Dioxin911/armachat/PCB/armachat.brd

## EAGLE design PCB/armachat.brd (2025-07-06)

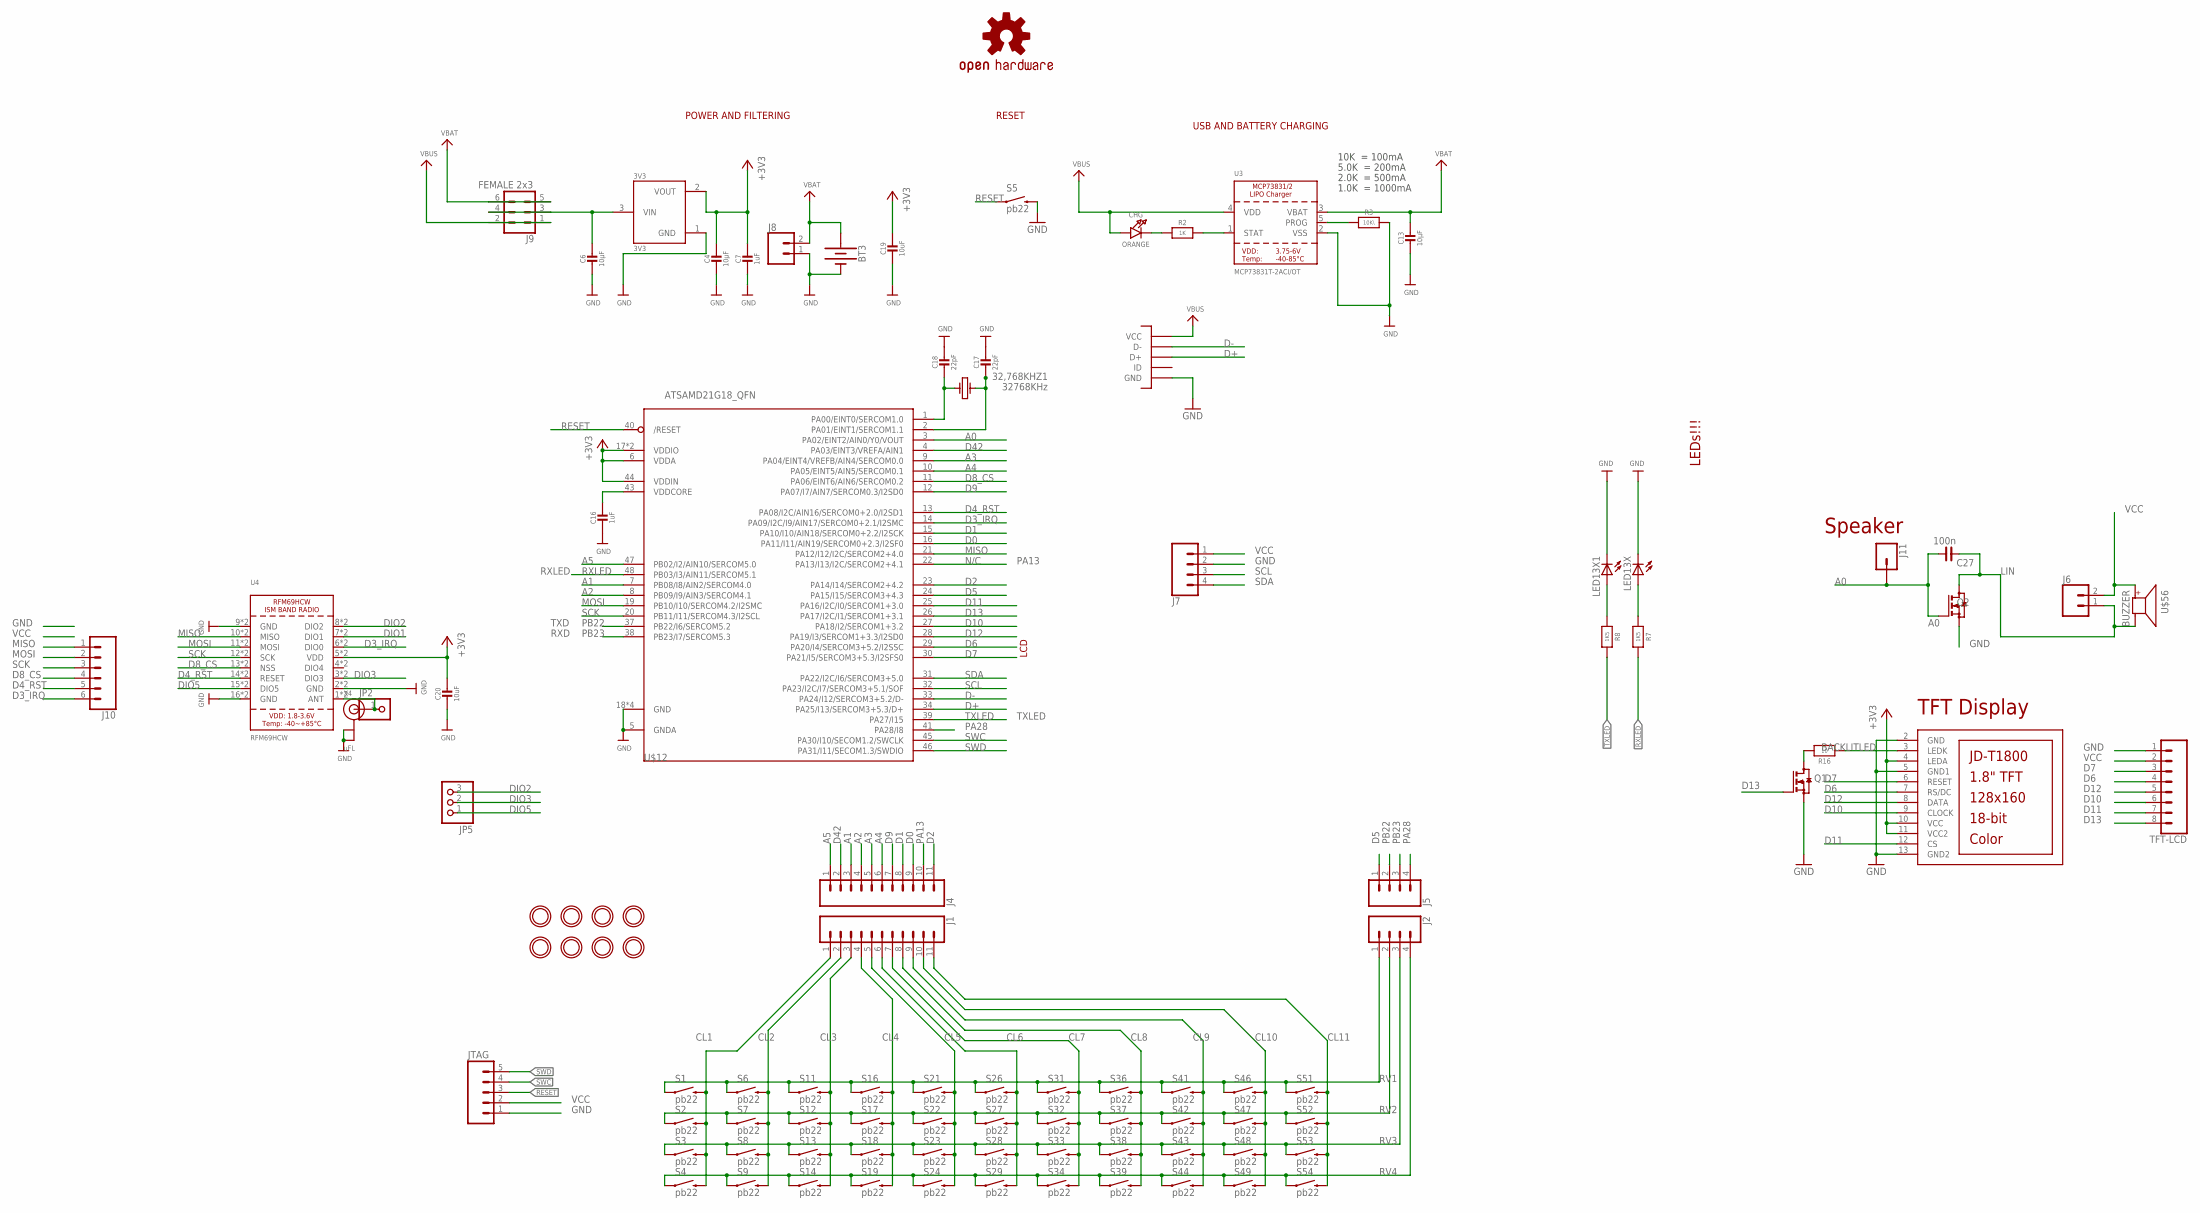
[picture p1: schematic armachat.sch]

Parts:
3V3: 3V3; SOT23
32,768KHZ1: 32768KHz; KX-327LT
BT3: BATTERY; 18650_HOLDER_SINGLE_THROUGH-HOLE
C4, C6, C13: 10µF; 0805-NO
C7, C16: 1uF; 0603-NO
C17, C18: 22pF; 0603-NO
C19: 10uF; 0603-NO
C20: 10uF; 0805-NO
C27: 100n; C0603
CHG: ORANGE; CHIPLED_0805_NOOUTLINE
J1, J4: CONN_111X11_NO_SILK; 1X11_NO_SILK
J2, J5, J7: CONN_041X04_NO_SILK; 1X04_NO_SILK
J6, J8: CONN_021X02_NO_SILK; 1X02_NO_SILK
J9: FEMALE 2x3; 2X3
J10: CONN_06NO_SILK_FEMALE_PTH; 1X06_NO_SILK
J11: CONN_01; 1X01
JP2: HEADER-1X1ROUND; 1X01_ROUND
JP5: HEADER-1X3ROUND; 1X03_ROUND
JTAG: M051.27MM; 1X05-1.27MM
LCD1: DISP_LCD_JDT1800; JD-T1800
LED13X, LED13X1: LED3MM
LOGO3: OSHW-LOGOS; OSHW-LOGO-S
Q1, Q2: BSS123; SOT23
R2: 1K; 0603-NO
R3: 10K\; 0603-NO
R7, R8: 1K5; _0603MP
R16: 10; 0603-NO
S1, S2, S3, S4, S6, S7, S8, S9, S11, S12, S13, S14, S16, S17, S18, S19, S21, S22, S23, S24, S26, S27, S28, S29, S31, S32, S33, S34, S36, S37, S38, S39, S41, S42, S43, S44, S46, S47, S48, S49, S51, S52, S53, S54: pb22; TACTILE-PTH
S5: pb22; TACTILE-SWITCH-1101NE
TFT-LCD: CONN_08"; 1X08
U3: MCP73831T-2ACI/OT; SOT23-5
U4: RFM69HCW
U$2, U$3, U$4, U$10, U$11, U$19, U$20, U$42: MOUNTINGHOLE2.0; MOUNTINGHOLE_2.0_PLATED
U$5: MICROUSB; MICRO_B
U$12: ATSAMD21G18_QFN; TQFN48_7MM
U$56: BUZZER; SMT-8585-BUZZER
X4: uFL; U.FL

Connections:
A0: C27.1, J11.1, Q2.1 (G), U$12.3 (PA02/EINT2/AIN0/Y0/VOUT)
A1: J4.3, U$12.7 (PB08/I8/AIN2/SERCOM4.0)
A2: J4.4, U$12.8 (PB09/I9/AIN3/SERCOM4.1)
A3: J4.5, U$12.9 (PA04/EINT4/VREFB/AIN4/SERCOM0.0)
A4: J4.6, U$12.10 (PA05/EINT5/AIN5/SERCOM0.1)
A5: J4.1, U$12.47 (PB02/I2/AIN10/SERCOM5.0)
ANT: JP2.1, U4.1 (ANT), U4.1P (ANT), X4.3 (SIGNAL)
BACKLITLED: LCD1.3 (LEDK), R16.1
CL1: J1.1, S1.3 (2), S2.3 (2), S3.3 (2), S4.3 (2)
CL2: J1.2, S6.3 (2), S7.3 (2), S8.3 (2), S9.3 (2)
CL3: J1.3, S11.3 (2), S12.3 (2), S13.3 (2), S14.3 (2)
CL4: J1.4, S16.3 (2), S17.3 (2), S18.3 (2), S19.3 (2)
CL5: J1.5, S21.3 (2), S22.3 (2), S23.3 (2), S24.3 (2)
CL6: J1.6, S26.3 (2), S27.3 (2), S28.3 (2), S29.3 (2)
CL7: J1.7, S31.3 (2), S32.3 (2), S33.3 (2), S34.3 (2)
CL8: J1.8, S36.3 (2), S37.3 (2), S38.3 (2), S39.3 (2)
CL9: J1.9, S41.3 (2), S42.3 (2), S43.3 (2), S44.3 (2)
CL10: J1.10, S46.3 (2), S47.3 (2), S48.3 (2), S49.3 (2)
CL11: J1.11, S51.3 (2), S52.3 (2), S53.3 (2), S54.3 (2)
D0: J4.9, U$12.16 (PA11/I11/AIN19/SERCOM0+2.3/I2SF0)
D1: J4.8, U$12.15 (PA10/I10/AIN18/SERCOM0+2.2/I2SCK)
D2: J4.11, U$12.23 (PA14/I14/SERCOM2+4.2)
D3_IRQ: J10.6, U4.6 (DIO0), U4.6P (DIO0), U$12.14 (PA09/I2C/I9/AIN17/SERCOM0+2.1/I2SMC)
D4_RST: J10.5, U4.14 (RESET), U4.14P (RESET), U$12.13 (PA08/I2C/AIN16/SERCOM0+2.0/I2SD1)
D5: J5.1, U$12.24 (PA15/I15/SERCOM3+4.3)
D6: LCD1.7 (RS/DC), TFT-LCD.4, U$12.29 (PA20/I4/SERCOM3+5.2/I2SSC)
D7: LCD1.6 (RESET), TFT-LCD.3, U$12.30 (PA21/I5/SERCOM3+5.3/I2SFS0)
D8_CS: J10.4, U4.13 (NSS), U4.13P (NSS), U$12.11 (PA06/EINT6/AIN6/SERCOM0.2)
D9: J4.7, U$12.12 (PA07/I7/AIN7/SERCOM0.3/I2SD0)
D10: LCD1.9 (CLOCK), TFT-LCD.6, U$12.27 (PA18/I2/SERCOM1+3.2)
D11: LCD1.12 (CS), TFT-LCD.7, U$12.25 (PA16/I2C/I0/SERCOM1+3.0)
D12: LCD1.8 (DATA), TFT-LCD.5, U$12.28 (PA19/I3/SERCOM1+3.3/I2SD0)
D13: Q1.1 (G), TFT-LCD.8, U$12.26 (PA17/I2C/I1/SERCOM1+3.1)
D42: J4.2, U$12.4 (PA03/EINT3/VREFA/AIN1)
D+: U$5.P3 (D+), U$12.34 (PA25/I13/SERCOM3+5.3/D+)
D-: U$5.P2 (D-), U$12.33 (PA24/I12/SERCOM3+5.2/D-)
DIO1: U4.7 (DIO1), U4.7P (DIO1)
DIO2: JP5.3, U4.8 (DIO2), U4.8P (DIO2)
DIO3: JP5.2, U4.3 (DIO3), U4.3P (DIO3)
DIO5: JP5.1, U4.15 (DIO5), U4.15P (DIO5)
GND: 3V3.1 (GND), BT3.CON(-) (-), C4.2, C6.2, C7.2, C13.2, C16.2, C17.2, C18.2, C19.2, C20.2, J7.2, J8.1, JTAG.1, LCD1.2 (GND), LCD1.5 (GND1), LCD1.13 (GND2), LED13X.K (C), LED13X1.K (C), Q1.2 (S), Q2.2 (S), R3.2, S5.2, TFT-LCD.1, U3.2 (VSS), U4.2 (GND), U4.2P (GND), U4.9 (GND), U4.9P (GND), U4.16 (GND), U4.16P (GND), U$5.GND1 (GND), U$5.GND2 (GND), U$5.GND3 (GND), U$5.GND4 (GND), U$5.GND7 (GND), U$5.GND8 (GND), U$5.P5 (GND), U$12.5 (GNDA), U$12.18 (GND), U$12.35 (GND), U$12.42 (GND), U$12.THERMAL (GND), X4.1 (GND), X4.2 (GND)
LIN: C27.2, J6.1, Q2.3 (D), U$56.-
MISO: J10.1, U4.10 (MISO), U4.10P (MISO), U$12.21 (PA12/I12/I2C/SERCOM2+4.0)
MOSI: J10.2, U4.11 (MOSI), U4.11P (MOSI), U$12.19 (PB10/I10/SERCOM4.2/I2SMC)
unnamed: 3V3.3 (VIN), C6.1, J9.3, J9.4
unnamed: CHG.C, R2.1
unnamed: R2.2, U3.1 (STAT)
unnamed: R3.1, U3.5 (PROG)
unnamed: LED13X1.A, R8.2
unnamed: 32,768KHZ1.4, C17.1, U$12.2 (PA01/EINT1/SERCOM1.1)
unnamed: 32,768KHZ1.1, C18.1, U$12.1 (PA00/EINT0/SERCOM1.0)
unnamed: Q1.3 (D), R16.2
unnamed: LED13X.A, R7.2
PA13: J4.10, U$12.22 (PA13/I13/I2C/SERCOM2+4.1)
PA28: J5.4, U$12.41 (PA28/I8)
PB22: J5.2, U$12.37 (PB22/I6/SERCOM5.2)
PB23: J5.3, U$12.38 (PB23/I7/SERCOM5.3)
RESET: JTAG.3, S5.1, U$12.40 (/RESET)
RV1: J2.1, S1.1, S6.1, S11.1, S16.1, S21.1, S26.1, S31.1, S36.1, S41.1, S46.1, S51.1
RV2: J2.2, S2.1, S7.1, S12.1, S17.1, S22.1, S27.1, S32.1, S37.1, S42.1, S47.1, S52.1
RV3: J2.3, S3.1, S8.1, S13.1, S18.1, S23.1, S28.1, S33.1, S38.1, S43.1, S48.1, S53.1
RV4: J2.4, S4.1, S9.1, S14.1, S19.1, S24.1, S29.1, S34.1, S39.1, S44.1, S49.1, S54.1
RXLED: R7.1, U$12.48 (PB03/I3/AIN11/SERCOM5.1)
SCK: J10.3, U4.12 (SCK), U4.12P (SCK), U$12.20 (PB11/I11/SERCOM4.3/I2SCL)
SCL: J7.3, U$12.32 (PA23/I2C/I7/SERCOM3+5.1/SOF)
SDA: J7.4, U$12.31 (PA22/I2C/I6/SERCOM3+5.0)
SWC: JTAG.4, U$12.45 (PA30/I10/SECOM1.2/SWCLK)
SWD: JTAG.5, U$12.46 (PA31/I11/SECOM1.3/SWDIO)
TXLED: R8.1, U$12.39 (PA27/I15)
VBAT: BT3.CON(+) (+), C13.1, J8.2, J9.5, J9.6, U3.3 (VBAT)
VBUS: CHG.A, J9.1, J9.2, U3.4 (VDD), U$5.P1 (VCC)
VCC: 3V3.2 (VOUT), C4.1, C7.1, C19.1, C20.1, J6.2, J7.1, JTAG.2, LCD1.4 (LEDA), LCD1.10 (VCC), LCD1.11 (VCC2), TFT-LCD.2, U4.5 (VDD), U4.5P (VDD), U$12.6 (VDDA), U$12.17 (VDDIO), U$12.36 (VDDIO), U$12.44 (VDDIN), U$56.+
VDDCORE1: C16.1, U$12.43 (VDDCORE)

Notes on the sheet:
LEDs!!!
POWER AND FILTERING
RESET
10K = 100mA
5.0K = 200mA
2.0K = 500mA
1.0K = 1000mA
N/C
TXLED
RXLED
TXD
RXD
USB AND BATTERY CHARGING
TFT Display
Speaker
LCD

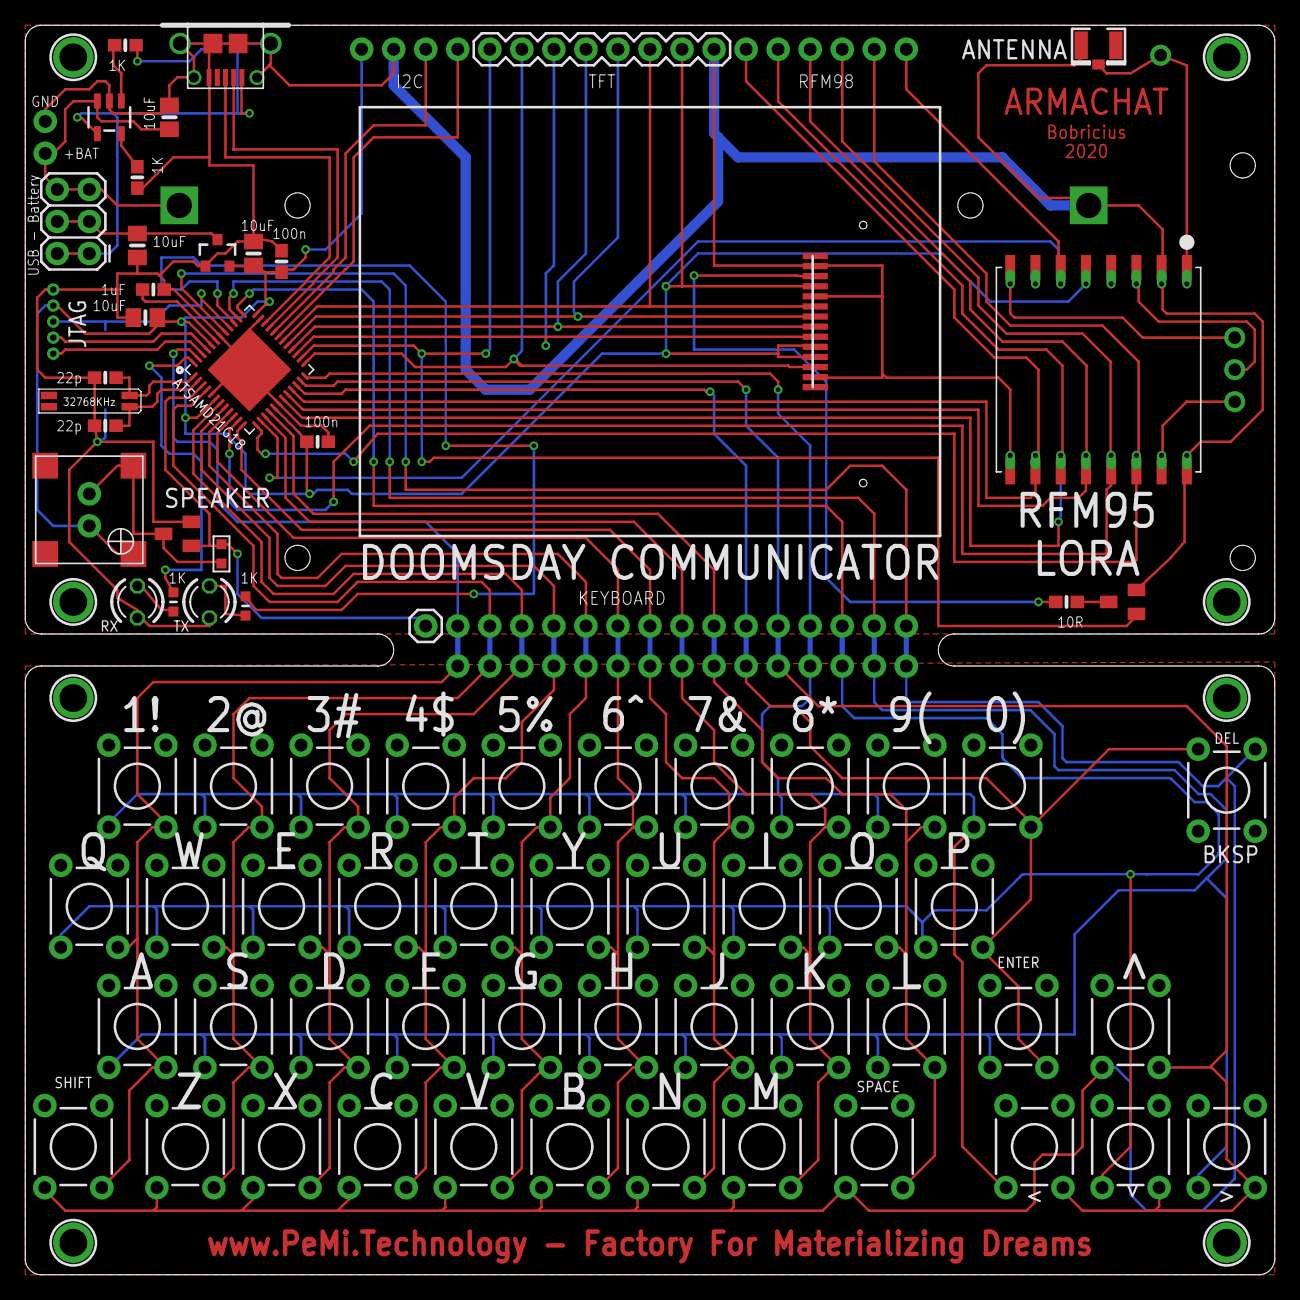
[picture p2: board armachat.brd from above]

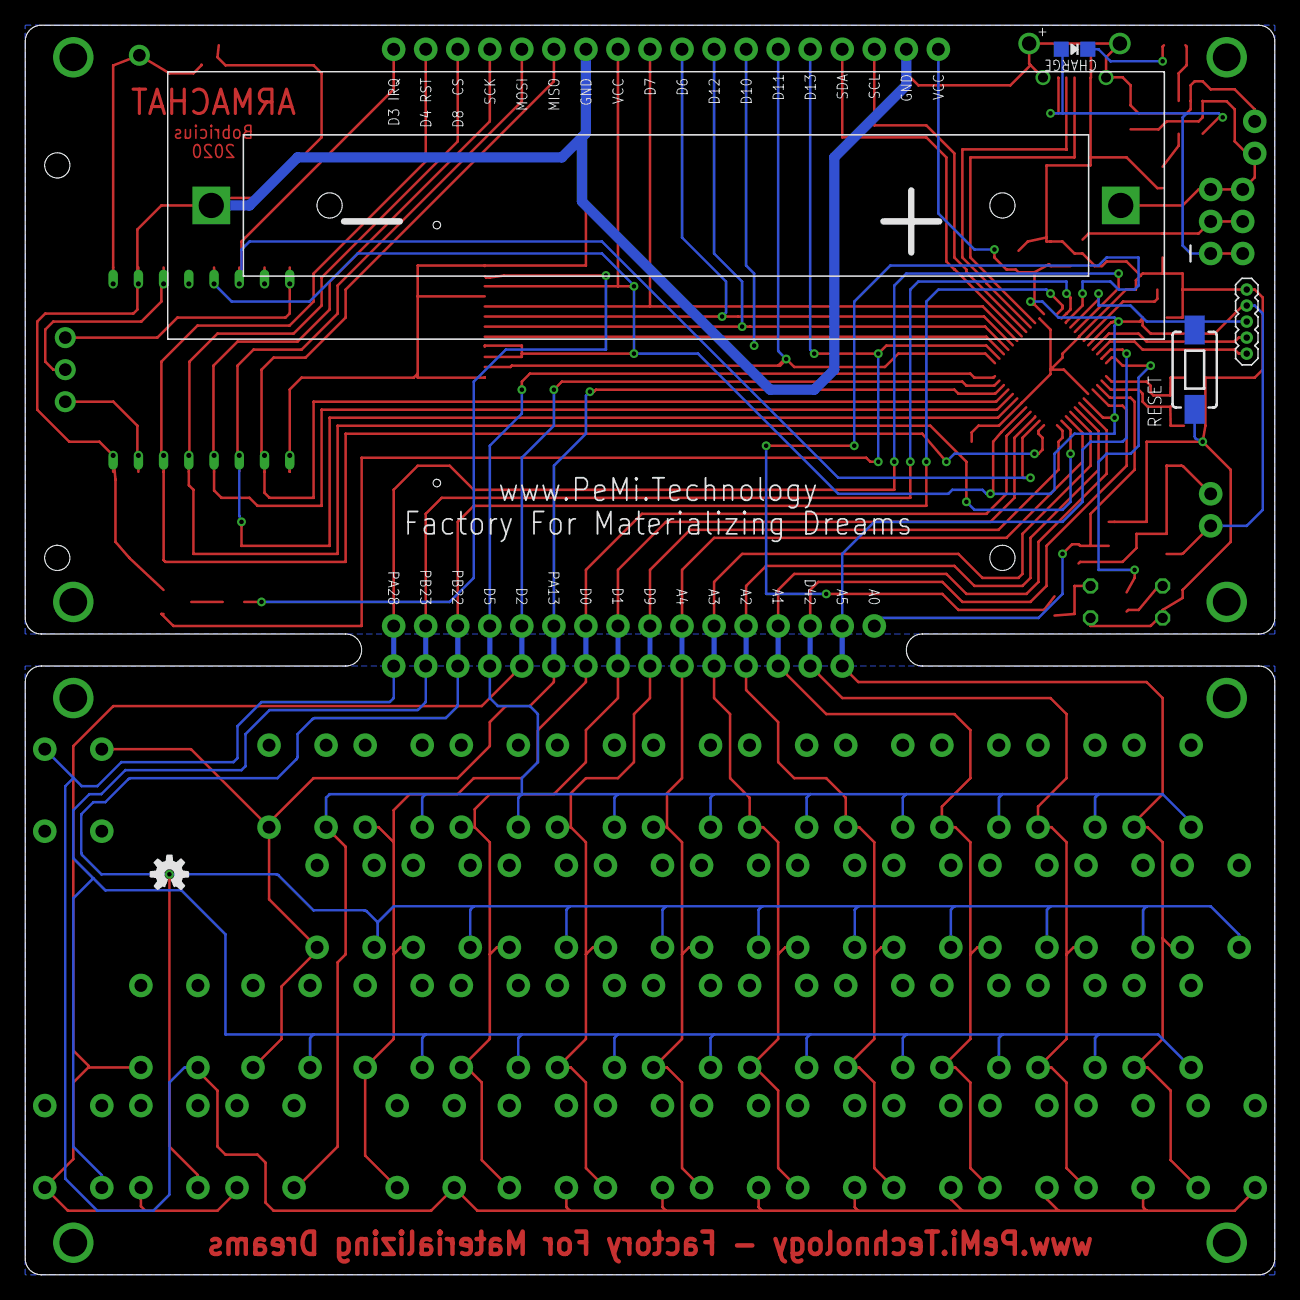
[picture p3: board armachat.brd from below]

Board: 2 copper layers, 99.1 x 99.1 mm, 98 parts (5 on the bottom side), 73 nets.
